cwm-peace/xiaofang/LowPower/README.md

# LowPower Library





Lightweight low power library for AVR/SAMD21 Moteino boards.
<br/>
By Felix Rusu, [LowPowerLab.com](http://LowPowerLab.com)
<br/>
Forked from [Low-Power](https://github.com/rocketscream/Low-Power).

Date: 08-08-2018

Devices Supported:
* ATMega168
* ATMega328P
* ATMega32U4
* ATMega644P
* ATMega1284P
* ATMega2560
* ATMega256RFR2
* ATSAMD21
