cwm-peace/xiaofang/如何用Arduino给ATMEGA328p裸片烧录引导程序/烧录引导程序.png

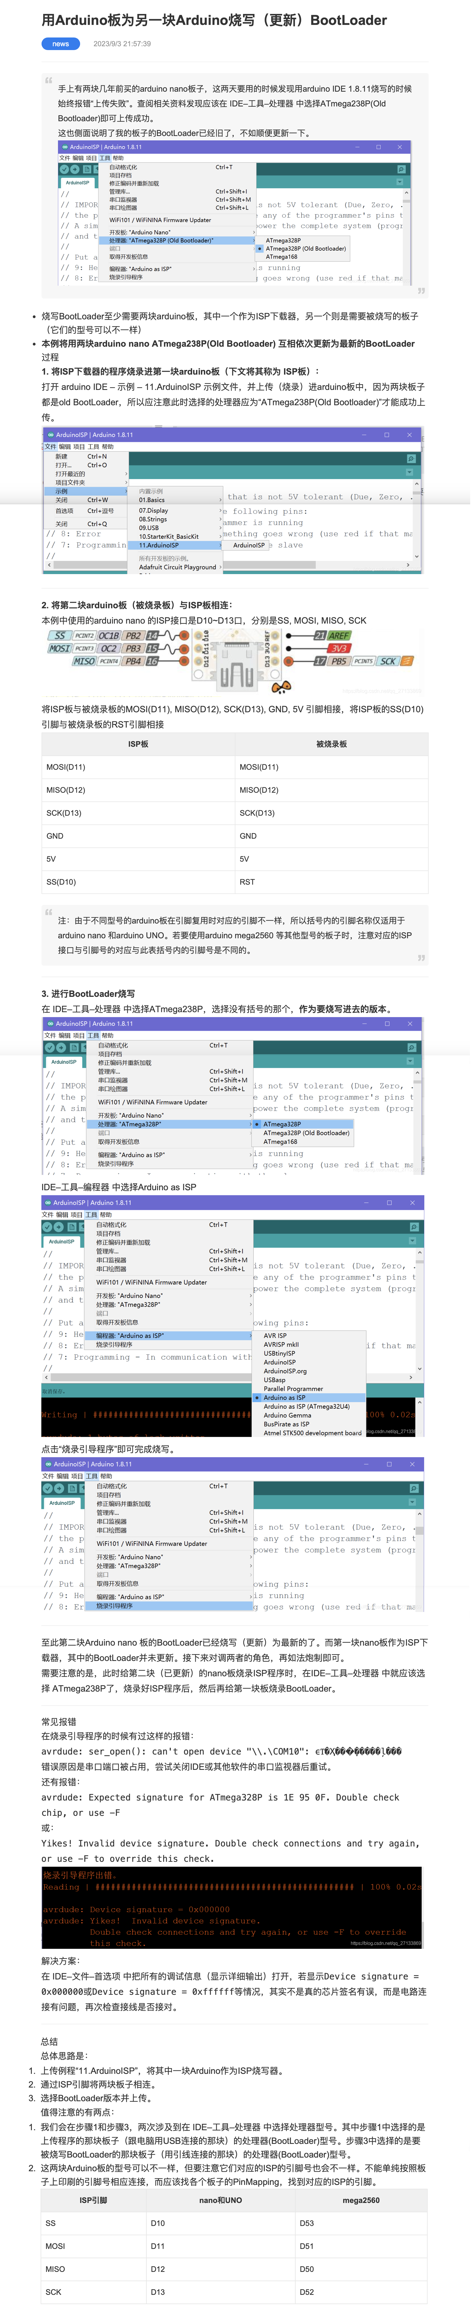
如何用Arduino给ATMEGA328p裸片烧录引导程序/烧录引导程序.png
