cwm-peace/xiaofang/小方开源-1.0（物料清单）.xlsx

编号 | 所需数量 | 零件 | 零件名称 | 参数 | 封装形式 | 引脚数量 | Manufacturer Part | Manufacturer | Supplier Part | Supplier
1 | 1 | AT24C16C-SSHM-T | 16K |  | SOIC-8_L4.9-W3.9-P1.27-LS6.0-BL | 8 | AT24C16C-SSHM-T | MICROCHIP(美国微芯) | C6480 | LCSC
2 | 1 | ATMEGA328P-AU | 328P |  | TQFP-32_L7.0-W7.0-P0.80-LS9.0-BL | 32 | ATMEGA328P-AU | MICROCHIP(美国微芯) | C3225551 | LCSC
3 | 1 | CH340X | 340X |  | MSOP-10_L3.0-W3.0-P0.50-LS5.0-BL | 10 | CH340X | WCH(南京沁恒) | C3035748 | LCSC
4 | 1 | IP5306ck | 5306-CK |  | ESOP-8_L4.9-W3.9-P1.27-LS6.0-BL-EP | 9 | IP5306 | INJOINIC(英集芯) | C181692 | LCSC
5 | 1 | MPU-6050 | 6050 |  | QFN-24_L4.0-W4.0-P0.50-BL-EP2.7 | 25 | MPU-6050 | TDK InvenSense(应美盛) | C24112 | LCSC
6 | 1 | AMS1117-3.3V | AMS1117 |  | SOT-223_L6.5-W3.5-P2.30-LS7.0-BR | 4 | AMS1117-3.3V | FM(富满) | C173386 | LCSC
7 | 2 | 20pF贴片电容 | C1,C2 | 20pF | C0603 | 2
8 | 8 | 100nF贴片电容 | C3,C9,C15,C16,C17,C19,C27,C30 | 100nF | C0603 | 2
9 | 6 | 10uF贴片电容 | C4,C5,C6,C8,C18,C26 | 10uF | C0603 | 2
10 | 5 | 22uF贴片电容 | C7,C20,C21,C22,C31 | 22uF | C0603 | 2
11 | 1 | 10nF贴片电容 | C28 | 10nF | C0603 | 2
12 | 1 | 2.2nF贴片电容 | C29 | 2.2nF | C0603 | 2
14 | 1 | 1uH贴片电感 | L2 | 1uH | L0603 | 2
15 | 1 | 点阵CS1288AW | 8x8方形点阵，共阴 |  | LED-TH_SLD1388DRA1GD | 16 | SLD1388DRA1GD | SUNLIGHT(光华) | C2913075 | LCSC
16 | 1 | LED_0603-R指示灯 | LED6 |  | LED_0603 | 2
17 | 1 | MAX7219M | MAX7219M |  | SOP-24_L15.2-W7.8-P1.27-LS10.6-BL | 24 | MAX7219M | HGSEMI(华冠) | C492110 | LCSC
18 | 9 | 4.7K贴片电阻 | R1,R3,R4,R5,R6,R9,R15,R20,R24 | 4.7K | R0603 | 2
19 | 2 | 10K贴片电阻 | R2,R26 | 10K | R0603 | 2
20 | 2 | 2R贴片电阻 | R7,R12 | 2R | R0603 | 2
21 | 3 | 1K贴片电阻 | R10,R11,R22 | 1K | R0603 | 2
22 | 1 | TYPE-C-16P 数据接口 | USB2 |  | USB-C-SMD_KH-TYPE-C-16P | 20 | KH-TYPE-C-16P | kinghelm(金航标) | C709357 | LCSC
23 | 1 | 16MHz无源晶振 | X1 | 16MHz | OSC-SMD_4P-L3.2-W2.5-BL | 4 | X322516MLB4SI | YXC(扬兴晶振) | C13738 | LCSC
24 | 1 | 电池 尺寸40x20x30mm | 200mAh | 200mAh
25 | 1 | 小喇叭 直径12mm 厚2mm
