cwm-peace/xiaofang/(list of files, drawings)

Other design files:
小方开源v1.0(硬件设计佳立创EDA专业版).epro
